dangnguyen06-ee/Autonomous_Rover_PCB/manufacturing/Autonomous_Rover_v1.pdf

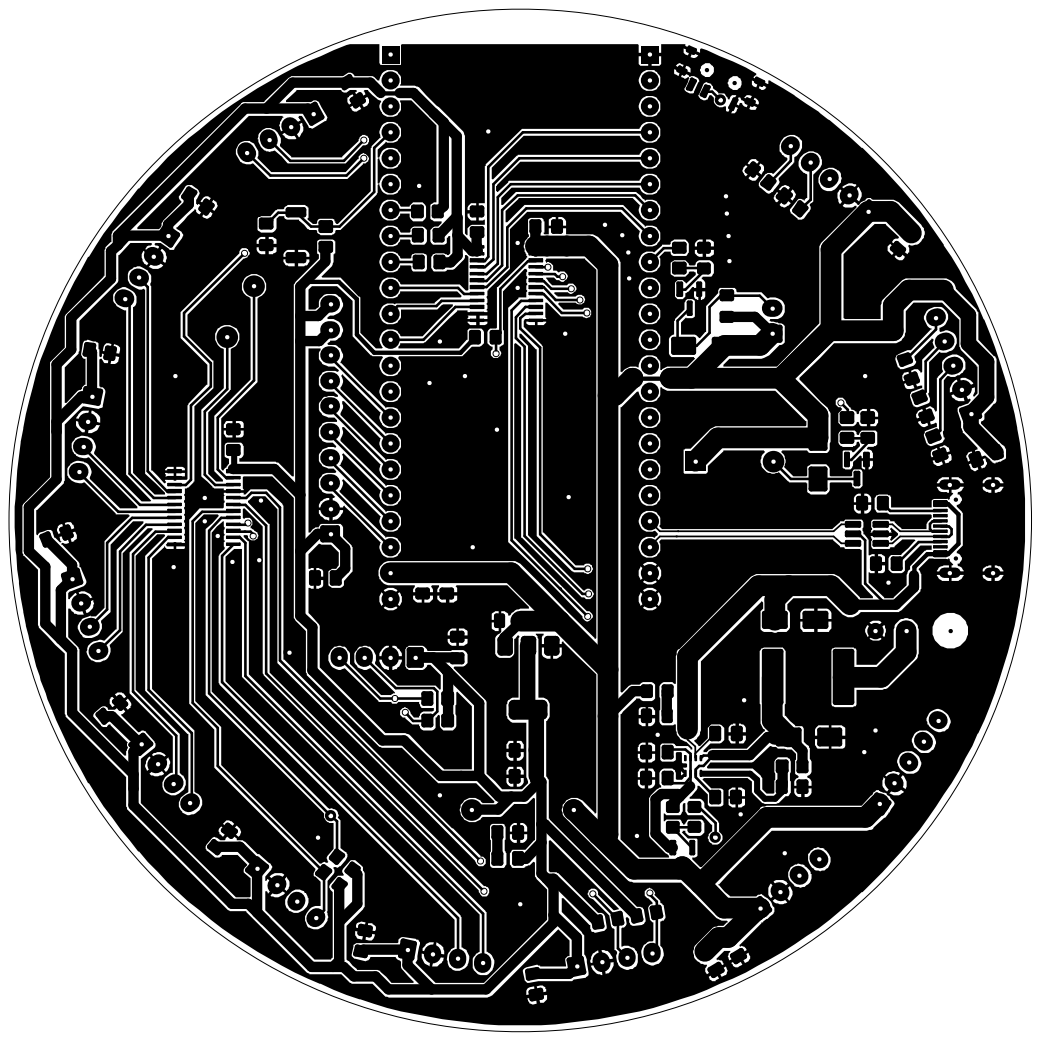
[picture p1: page 1]
