dangnguyen06-ee/Autonomous_Rover_PCB/Autonomous_Rover.kicad_pcb

## KiCad design Autonomous_Rover.kicad_pcb (2026-11-10)

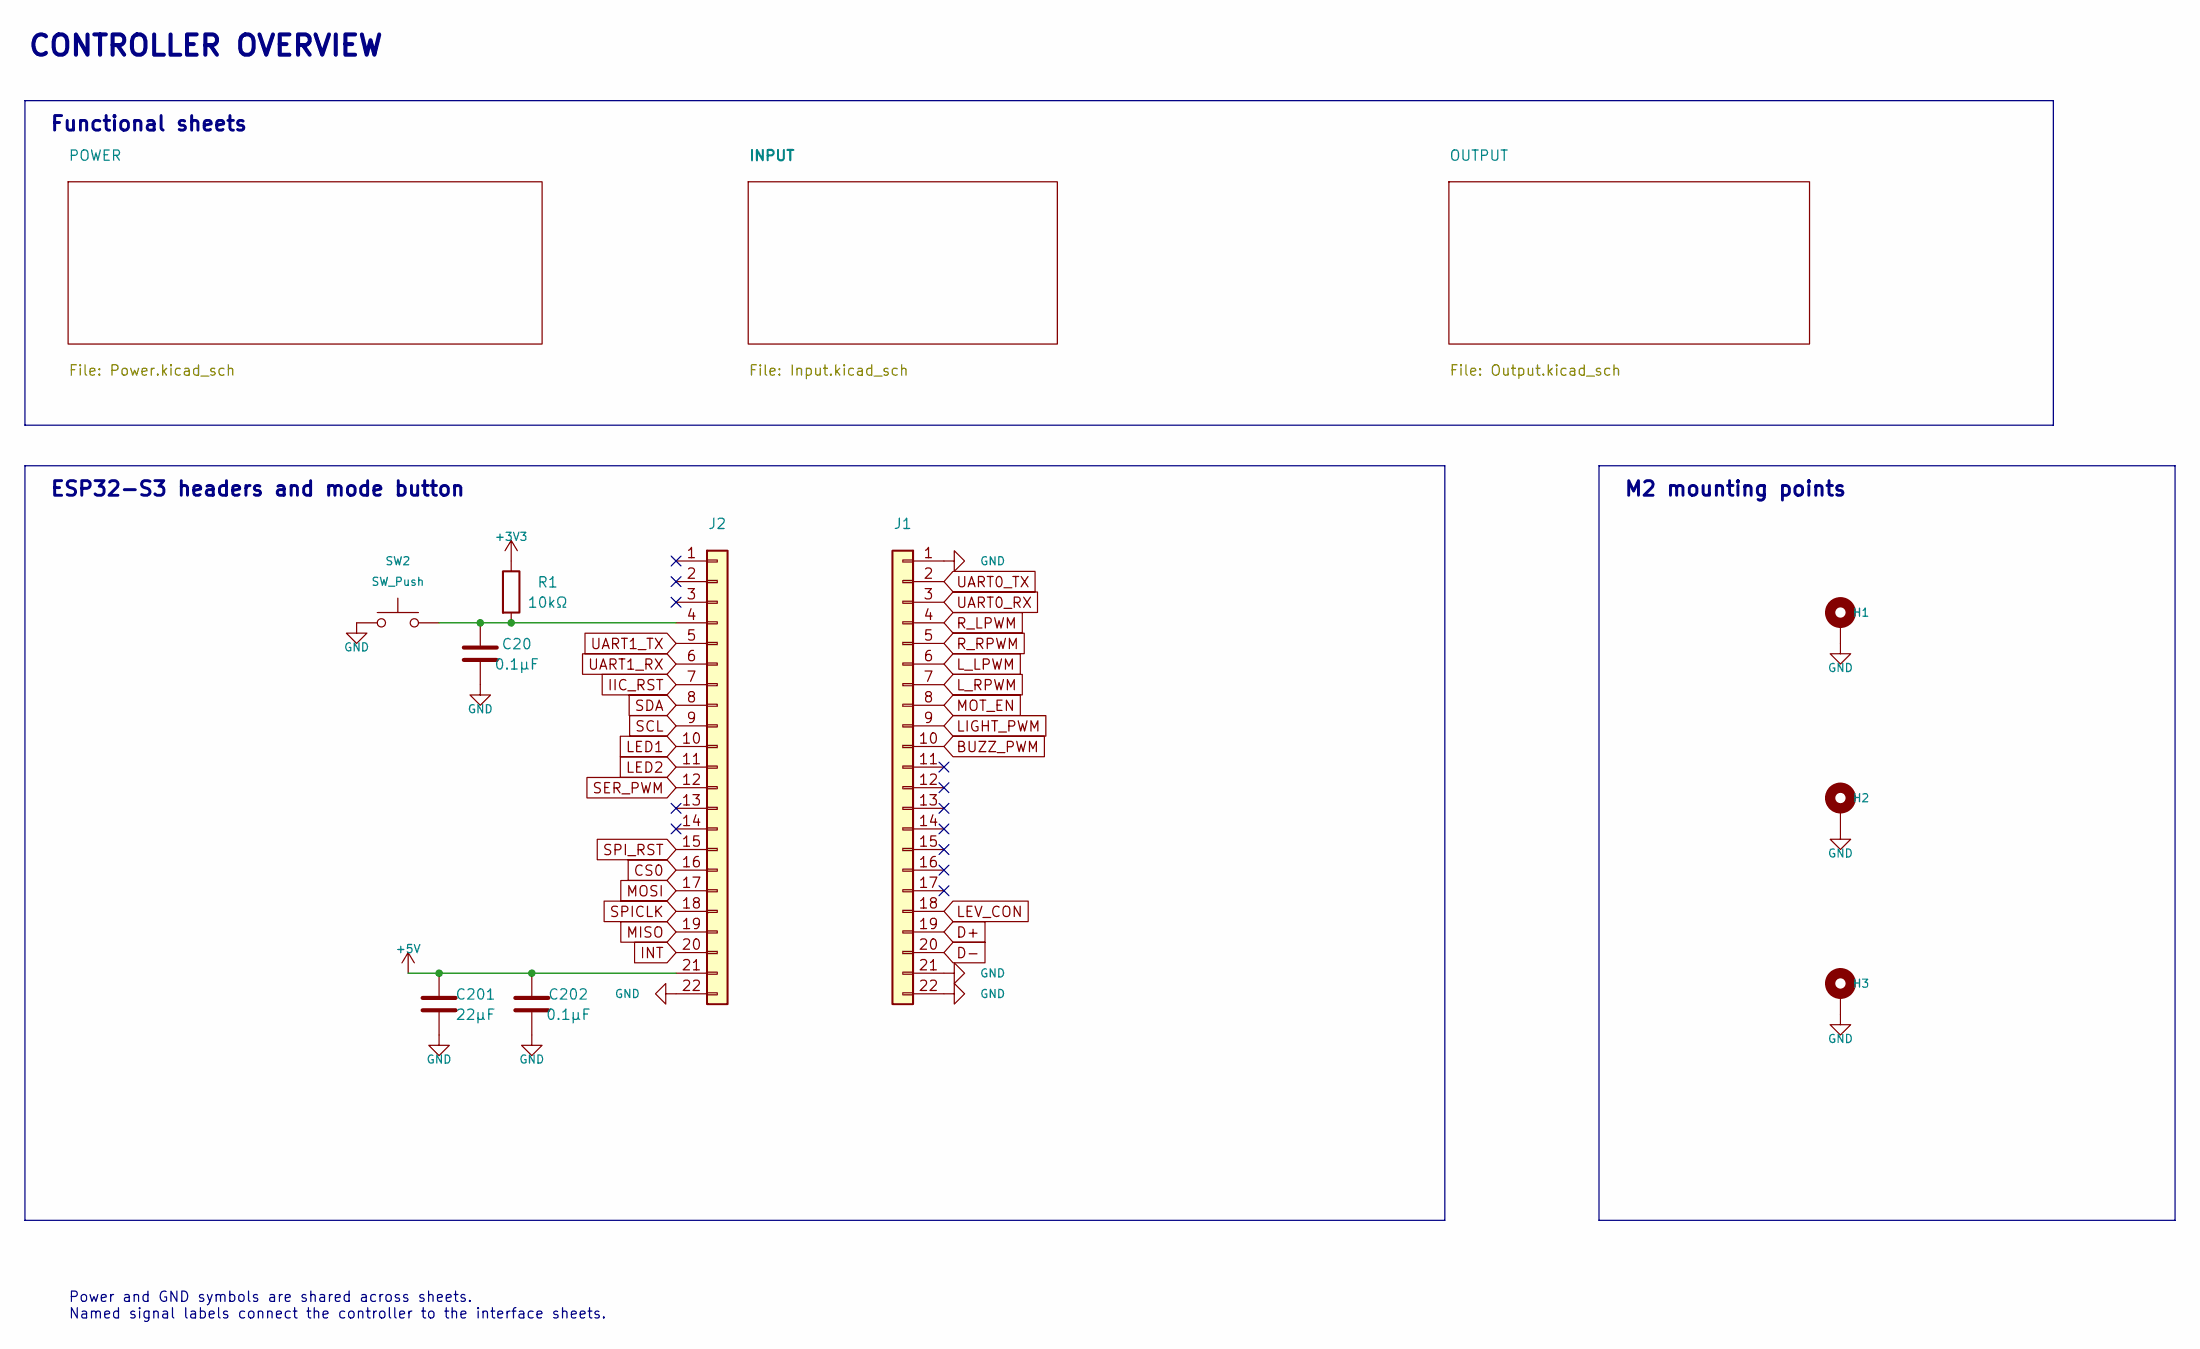
[picture p2: schematic Autonomous_Rover.kicad_sch, Parker the Rover - controller overview]

Parts:
C20, C202: 0.1µF; C_0805_2012Metric_Pad1.18x1.45mm_HandSolder
C201: 22µF; C_0805_2012Metric_Pad1.18x1.45mm_HandSolder
H1, H2, H3: M2; MountingHole_2.2mm_M2_ISO7380_Pad
J1: ESP32_R; PinSocket_1x22_P2.54mm_Vertical
J2: ESP32_L; PinSocket_1x22_P2.54mm_Vertical
R1: 10kΩ; R_0805_2012Metric_Pad1.20x1.40mm_HandSolder
SW2: SW_Push; SW_SPST_TS-1088-xR020

Connections:
+3V3: R1.1; also elsewhere on the board
+5V: C201.2, C202.2, J2.21; also elsewhere on the board
BUZZ_PWM: J1.10; also elsewhere on the board
CS0: J2.16; also elsewhere on the board
D+: J1.19; also elsewhere on the board
D-: J1.20; also elsewhere on the board
GND: C20.1, C201.1, C202.1, H1.1 (1_1), H2.1 (1_1), H3.1 (1_1), J1.1, J1.21, J1.22, J2.22, SW2.1; also elsewhere on the board
IIC_RST: J2.7; also elsewhere on the board
INT: J2.20; also elsewhere on the board
LED1: J2.10; also elsewhere on the board
LED2: J2.11; also elsewhere on the board
LEV_CON: J1.18; also elsewhere on the board
LIGHT_PWM: J1.9; also elsewhere on the board
L_LPWM: J1.6; also elsewhere on the board
L_RPWM: J1.7; also elsewhere on the board
MISO: J2.19; also elsewhere on the board
MOSI: J2.17; also elsewhere on the board
MOT_EN: J1.8; also elsewhere on the board
unnamed: C20.2, J2.4, R1.2, SW2.2
R_LPWM: J1.4; also elsewhere on the board
R_RPWM: J1.5; also elsewhere on the board
SCL: J2.9; also elsewhere on the board
SDA: J2.8; also elsewhere on the board
SER_PWM: J2.12; also elsewhere on the board
SPICLK: J2.18; also elsewhere on the board
SPI_RST: J2.15; also elsewhere on the board
UART0_RX: J1.3; also elsewhere on the board
UART0_TX: J1.2; also elsewhere on the board
UART1_RX: J2.6; also elsewhere on the board
UART1_TX: J2.5; also elsewhere on the board

Notes on the sheet:
M2 mounting points
Functional sheets
ESP32-S3 headers and mode button
CONTROLLER OVERVIEW
Power and GND symbols are shared across sheets. Named signal labels connect the controller to the interface sheets.

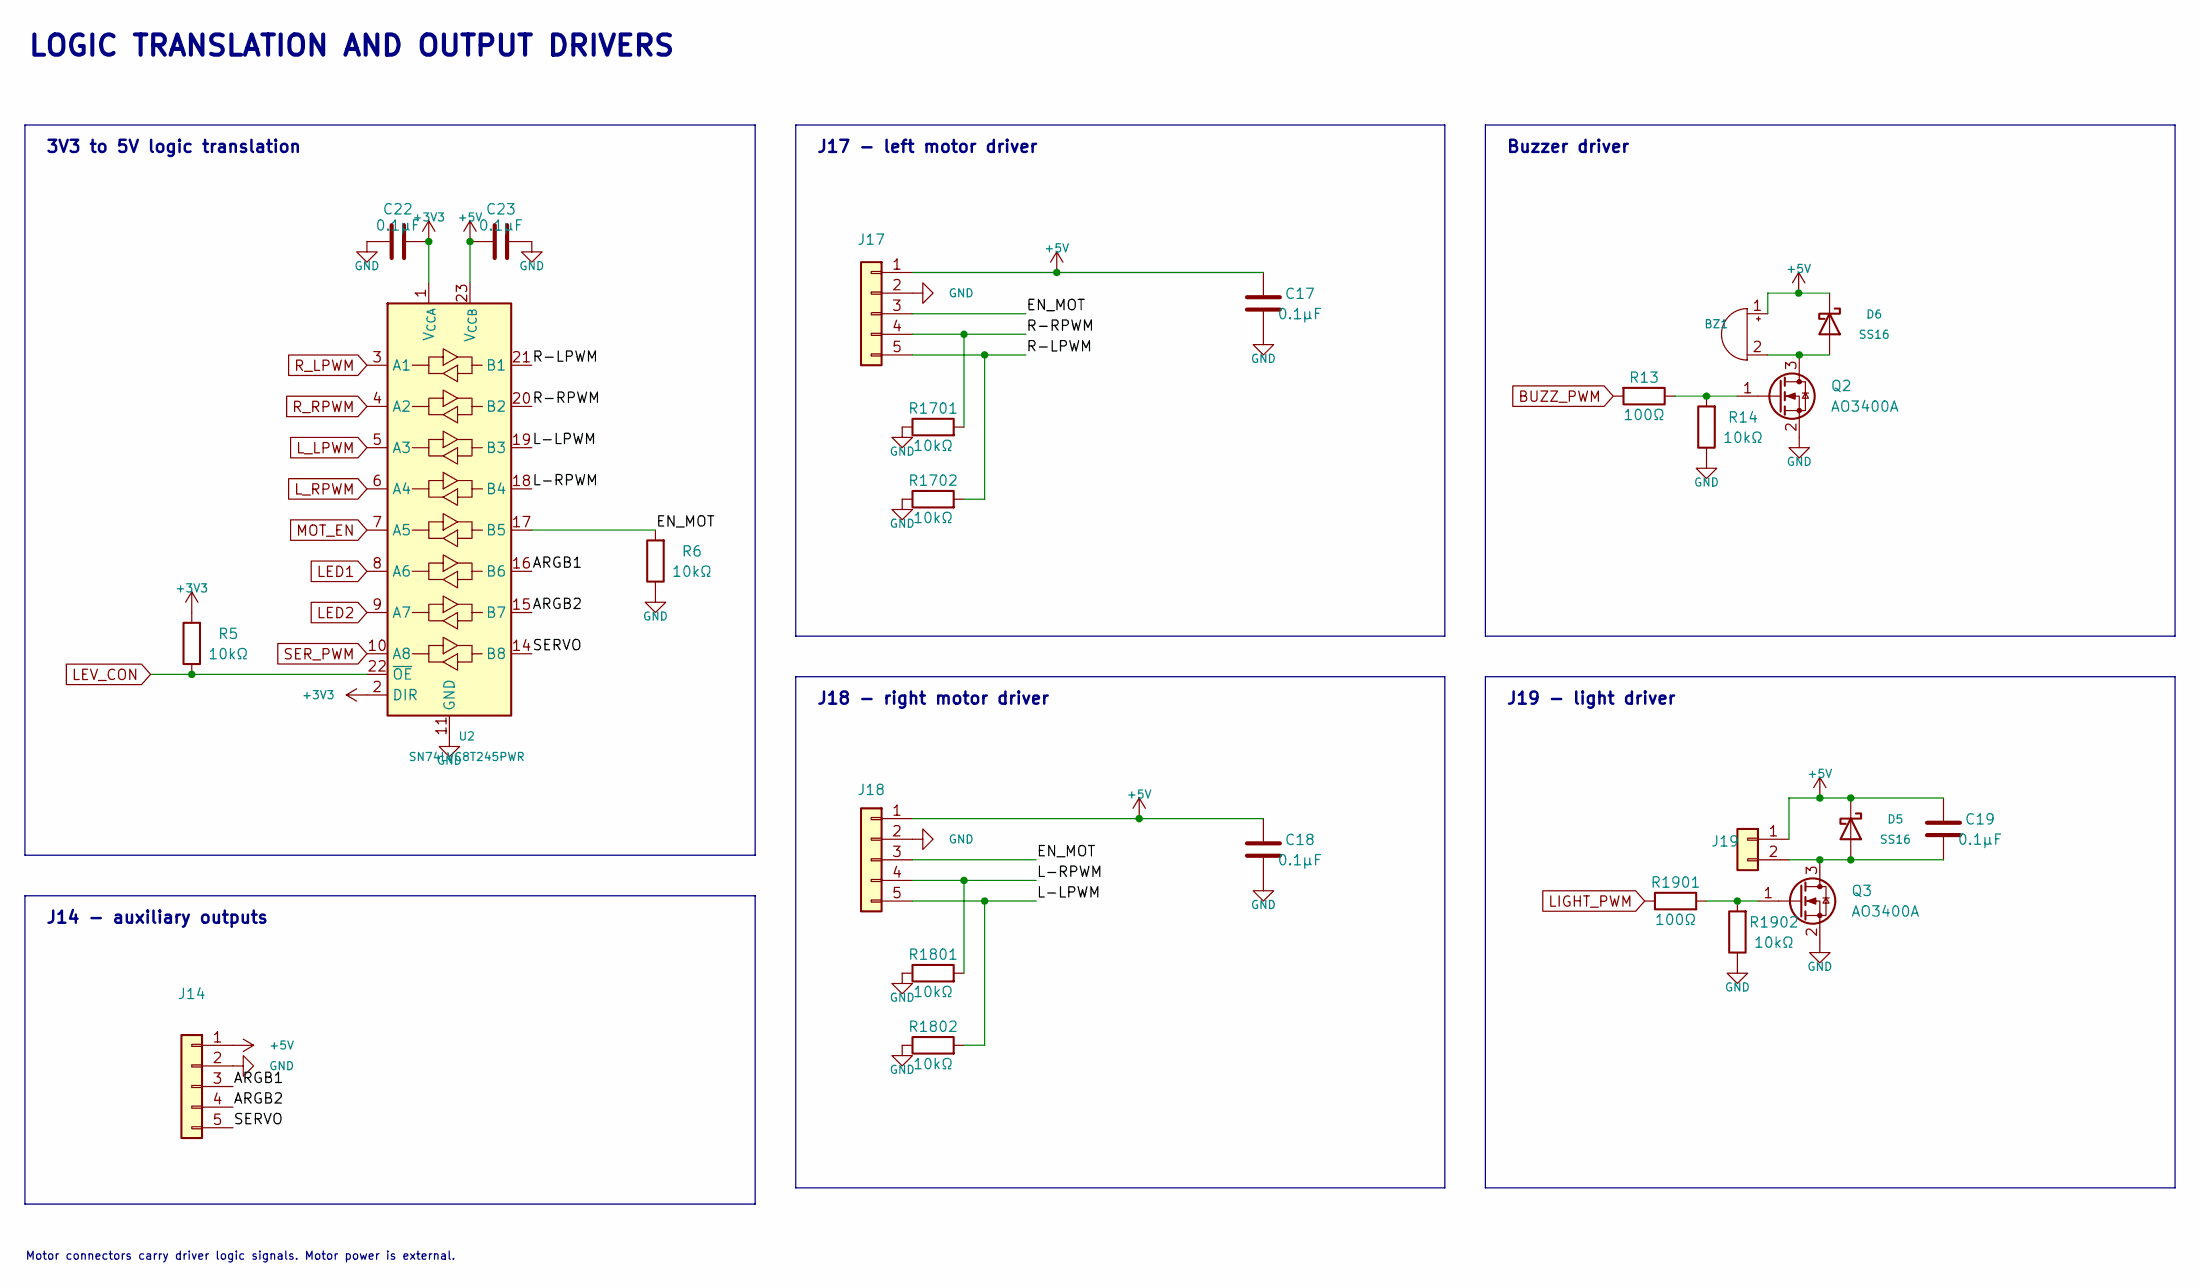
[picture p3: schematic Output.kicad_sch, Parker the Rover - logic translation and output drivers]

Parts:
BZ1: Buzzer; Buzzer_12x9.5RM7.6
C17, C18, C19, C22, C23: 0.1µF; C_0805_2012Metric_Pad1.18x1.45mm_HandSolder
D5, D6: SS16; D_SMA
J14: 5V_Con; JST_XH_B5B-XH-A_1x05_P2.50mm_Vertical
J17: L_MOT; JST_XH_B5B-XH-A_1x05_P2.50mm_Vertical
J18: R_MOT; JST_XH_B5B-XH-A_1x05_P2.50mm_Vertical
J19: BEAM_LIGHT; JST_XH_B2B-XH-A_1x02_P2.50mm_Vertical
Q2, Q3: AO3400A; SOT-23
R5, R6, R14, R1701, R1702, R1801, R1802, R1902: 10kΩ; R_0805_2012Metric_Pad1.20x1.40mm_HandSolder
R13, R1901: 100Ω; R_0805_2012Metric_Pad1.20x1.40mm_HandSolder
U2: SN74LVC8T245PWR; TSSOP-24_4.4x7.8mm_P0.65mm

Connections:
+3V3: C22.2, R5.2, U2.1 (V_{CCA}), U2.2 (DIR); also elsewhere on the board
+5V: BZ1.1 (+), C17.2, C18.2, C19.1, C23.2, D5.1 (K), D6.1 (K), J14.1, J17.1, J18.1, J19.1, U2.23 (V_{CCB}), U2.24 (V_{CCB}); also elsewhere on the board
/OUTPUT/ARGB1: J14.3, U2.16 (B6)
/OUTPUT/ARGB2: J14.4, U2.15 (B7)
/OUTPUT/EN_MOT: J17.3, J18.3, R6.2, U2.17 (B5)
/OUTPUT/L-LPWM: J18.5, R1802.2, U2.19 (B3)
/OUTPUT/L-RPWM: J18.4, R1801.2, U2.18 (B4)
/OUTPUT/R-LPWM: J17.5, R1702.2, U2.21 (B1)
/OUTPUT/R-RPWM: J17.4, R1701.2, U2.20 (B2)
/OUTPUT/SERVO: J14.5, U2.14 (B8)
BUZZ_PWM: R13.2; also elsewhere on the board
GND: C17.1, C18.1, C22.1, C23.1, J14.2, J17.2, J18.2, Q2.2 (S), Q3.2 (S), R6.1, R14.1, R1701.1, R1702.1, R1801.1, R1802.1, R1902.1, U2.11 (GND), U2.12 (GND), U2.13 (GND); also elsewhere on the board
LED1: U2.8 (A6); also elsewhere on the board
LED2: U2.9 (A7); also elsewhere on the board
LEV_CON: R5.1, U2.22 (~OE); also elsewhere on the board
LIGHT_PWM: R1901.1; also elsewhere on the board
L_LPWM: U2.5 (A3); also elsewhere on the board
L_RPWM: U2.6 (A4); also elsewhere on the board
MOT_EN: U2.7 (A5); also elsewhere on the board
unnamed: BZ1.2 (-), D6.2 (A), Q2.3 (D)
unnamed: C19.2, D5.2 (A), J19.2, Q3.3 (D)
unnamed: Q2.1 (G), R13.1, R14.2
unnamed: Q3.1 (G), R1901.2, R1902.2
R_LPWM: U2.3 (A1); also elsewhere on the board
R_RPWM: U2.4 (A2); also elsewhere on the board
SER_PWM: U2.10 (A8); also elsewhere on the board

Notes on the sheet:
3V3 to 5V logic translation
Motor connectors carry driver logic signals. Motor power is external.
J17 - left motor driver
J14 - auxiliary outputs
J18 - right motor driver
LOGIC TRANSLATION AND OUTPUT DRIVERS
J19 - light driver
Buzzer driver

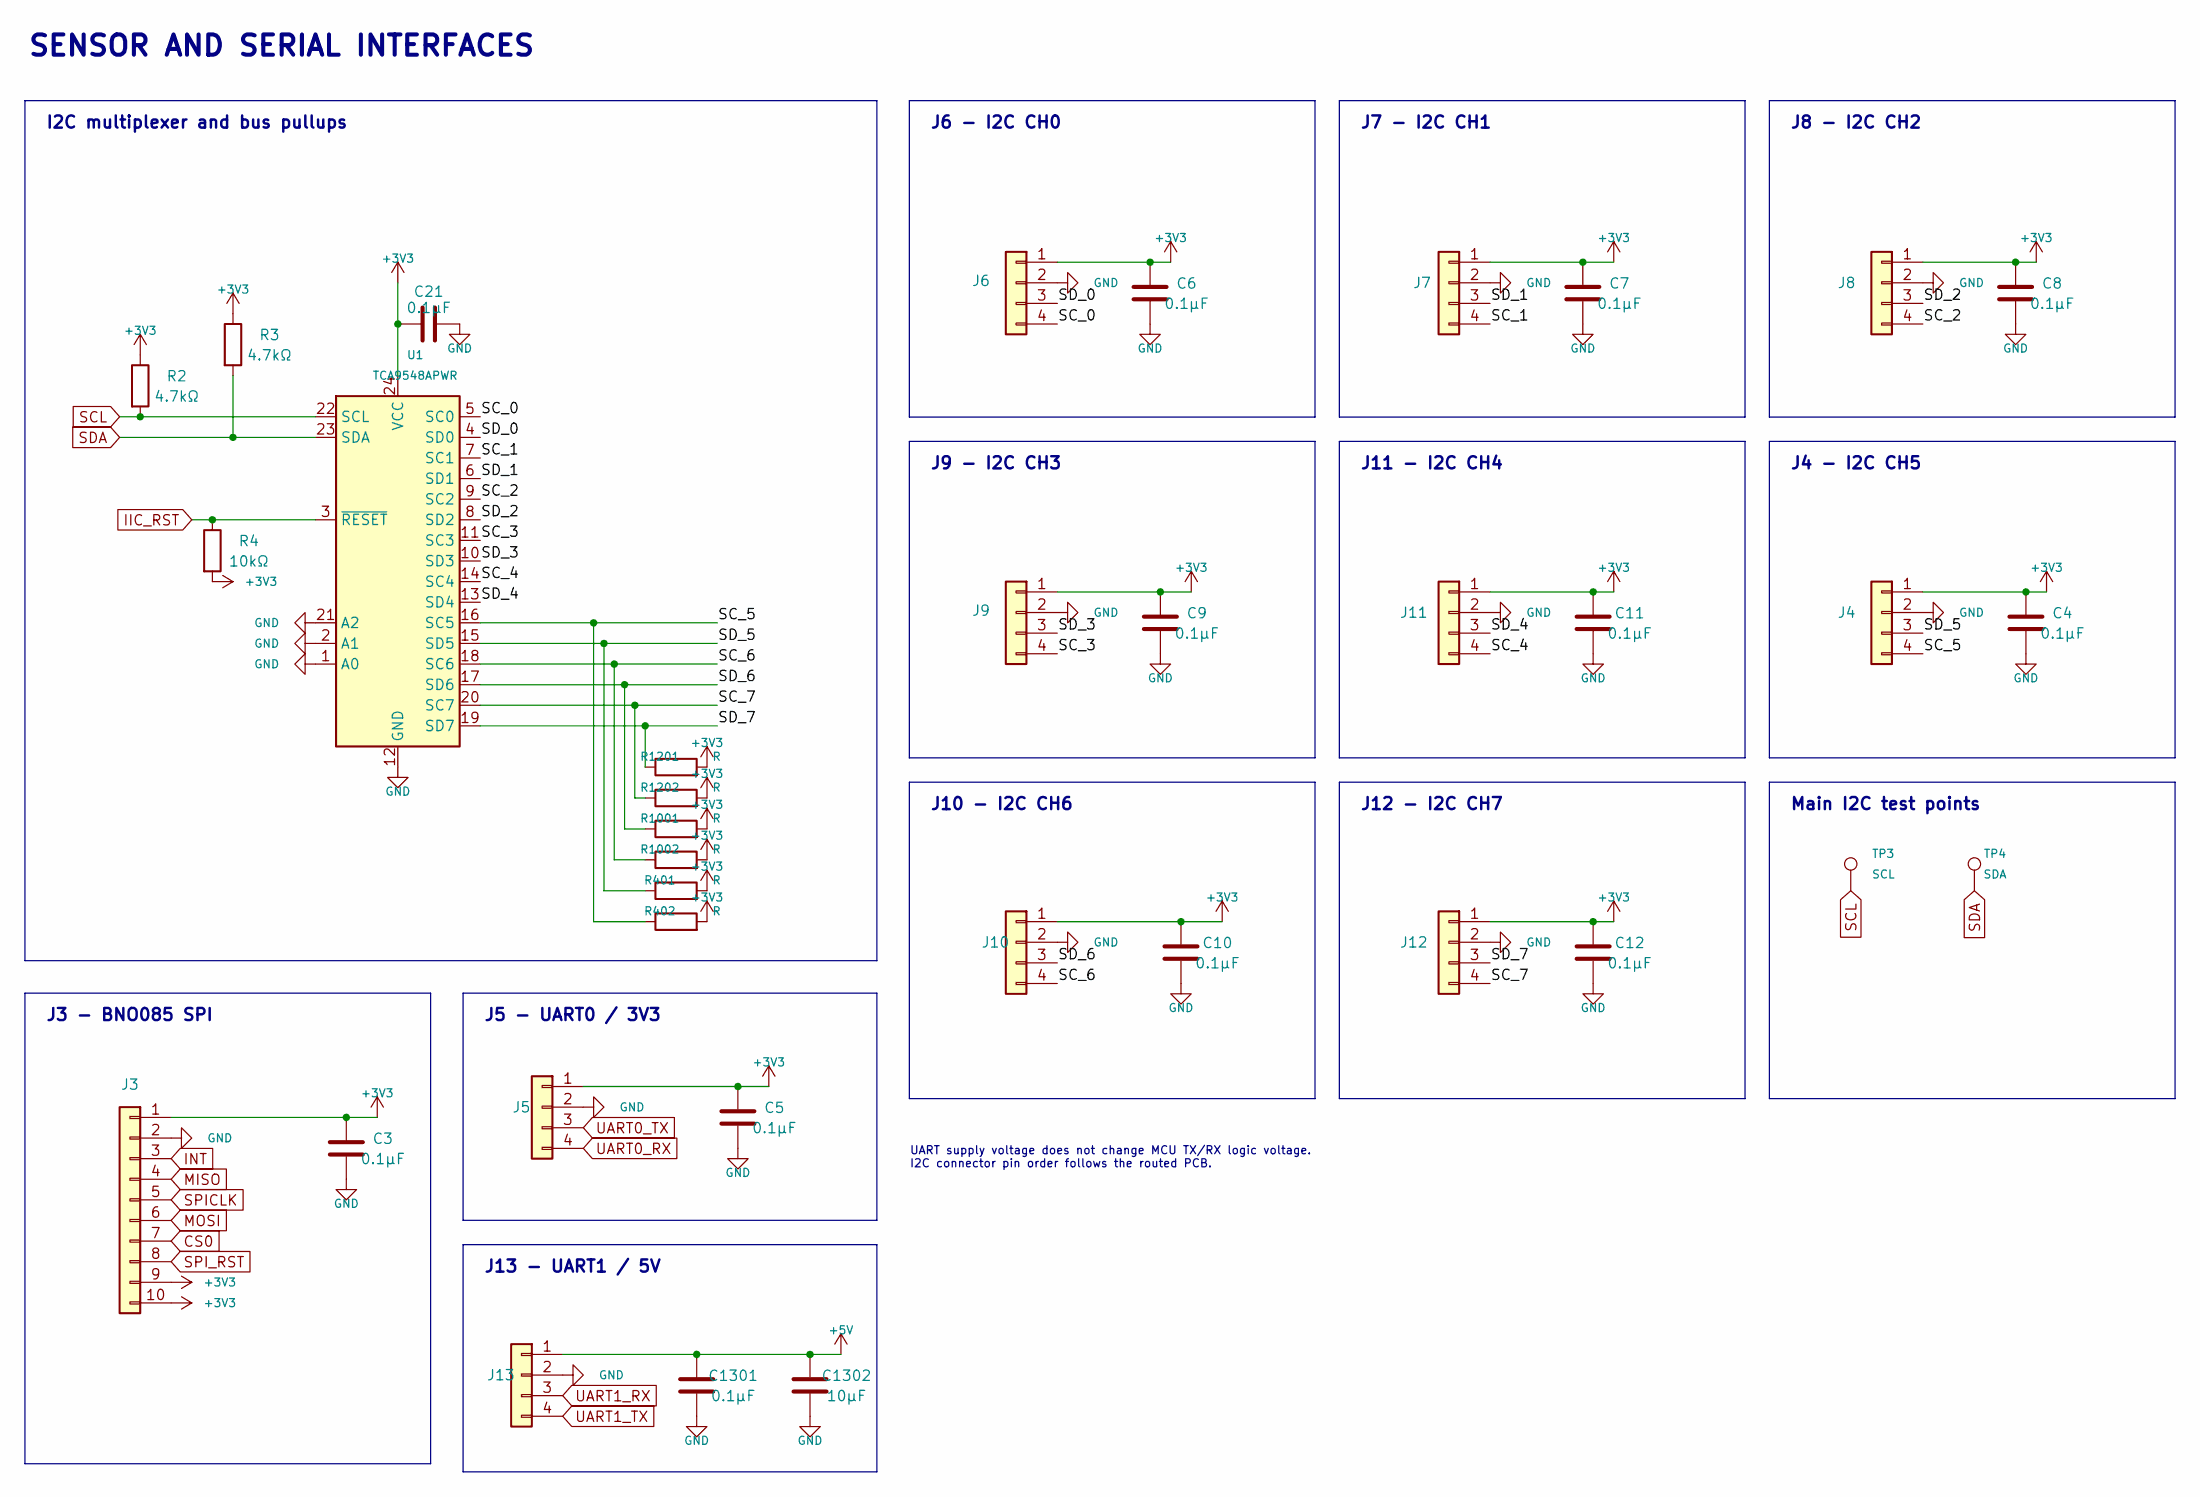
[picture p4: schematic Input.kicad_sch, Parker the Rover - sensor and serial interfaces]

Parts:
C3, C4, C5, C6, C7, C8, C9, C10, C11, C12, C21, C1301: 0.1µF; C_0805_2012Metric_Pad1.18x1.45mm_HandSolder
C1302: 10µF; C_0805_2012Metric_Pad1.18x1.45mm_HandSolder
J3: BNO085; JST_XH_B10B-XH-A_1x10_P2.50mm_Vertical
J4: I2C_CH5; JST_XH_B4B-XH-A_1x04_P2.50mm_Vertical
J5: UART0_3V; JST_XH_B4B-XH-A_1x04_P2.50mm_Vertical
J6: I2C_CH0; JST_XH_B4B-XH-A_1x04_P2.50mm_Vertical
J7: I2C_CH1; JST_XH_B4B-XH-A_1x04_P2.50mm_Vertical
J8: I2C_CH2; JST_XH_B4B-XH-A_1x04_P2.50mm_Vertical
J9: I2C_CH3; JST_XH_B4B-XH-A_1x04_P2.50mm_Vertical
J10: I2C_CH6; JST_XH_B4B-XH-A_1x04_P2.50mm_Vertical
J11: I2C_CH4; JST_XH_B4B-XH-A_1x04_P2.50mm_Vertical
J12: I2C_CH7; JST_XH_B4B-XH-A_1x04_P2.50mm_Vertical
J13: UART1_5V; JST_XH_B4B-XH-A_1x04_P2.50mm_Vertical
R2, R3: 4.7kΩ; R_0805_2012Metric_Pad1.20x1.40mm_HandSolder
R4: 10kΩ; R_0805_2012Metric_Pad1.20x1.40mm_HandSolder
R401, R402, R1001, R1002, R1201, R1202: R; R_0805_2012Metric_Pad1.20x1.40mm_HandSolder
TP3: SCL; TestPoint_Loop_D1.80mm_Drill1.0mm_Beaded
TP4: SDA; TestPoint_Loop_D1.80mm_Drill1.0mm_Beaded
U1: TCA9548APWR; TSSOP-24_4.4x7.8mm_P0.65mm

Connections:
+3V3: C3.1, C4.1, C5.2, C6.1, C7.1, C8.1, C9.1, C10.1, C11.1, C12.1, C21.1, J3.1, J3.9, J3.10, J4.1, J5.1, J6.1, J7.1, J8.1, J9.1, J10.1, J11.1, J12.1, R2.1, R3.1, R4.2, R401.2, R402.2, R1001.2, R1002.2, R1201.2, R1202.2, U1.24 (VCC); also elsewhere on the board
+5V: C1301.2, C1302.2, J13.1; also elsewhere on the board
/INPUT/SC_0: J6.4, U1.5 (SC0)
/INPUT/SC_1: J7.4, U1.7 (SC1)
/INPUT/SC_2: J8.4, U1.9 (SC2)
/INPUT/SC_3: J9.4, U1.11 (SC3)
/INPUT/SC_4: J11.4, U1.14 (SC4)
/INPUT/SC_5: J4.4, R402.1, U1.16 (SC5)
/INPUT/SC_6: J10.4, R1002.1, U1.18 (SC6)
/INPUT/SC_7: J12.4, R1202.1, U1.20 (SC7)
/INPUT/SD_0: J6.3, U1.4 (SD0)
/INPUT/SD_1: J7.3, U1.6 (SD1)
/INPUT/SD_2: J8.3, U1.8 (SD2)
/INPUT/SD_3: J9.3, U1.10 (SD3)
/INPUT/SD_4: J11.3, U1.13 (SD4)
/INPUT/SD_5: J4.3, R401.1, U1.15 (SD5)
/INPUT/SD_6: J10.3, R1001.1, U1.17 (SD6)
/INPUT/SD_7: J12.3, R1201.1, U1.19 (SD7)
CS0: J3.7; also elsewhere on the board
GND: C3.2, C4.2, C5.1, C6.2, C7.2, C8.2, C9.2, C10.2, C11.2, C12.2, C21.2, C1301.1, C1302.1, J3.2, J4.2, J5.2, J6.2, J7.2, J8.2, J9.2, J10.2, J11.2, J12.2, J13.2, U1.1 (A0), U1.2 (A1), U1.12 (GND), U1.21 (A2); also elsewhere on the board
IIC_RST: R4.1, U1.3 (~RESET); also elsewhere on the board
INT: J3.3; also elsewhere on the board
MISO: J3.4; also elsewhere on the board
MOSI: J3.6; also elsewhere on the board
SCL: R2.2, TP3.1 (1_1), U1.22 (SCL); also elsewhere on the board
SDA: R3.2, TP4.1 (1_1), U1.23 (SDA); also elsewhere on the board
SPICLK: J3.5; also elsewhere on the board
SPI_RST: J3.8; also elsewhere on the board
UART0_RX: J5.4; also elsewhere on the board
UART0_TX: J5.3; also elsewhere on the board
UART1_RX: J13.3; also elsewhere on the board
UART1_TX: J13.4; also elsewhere on the board

Notes on the sheet:
J7 - I2C CH1
J12 - I2C CH7
J8 - I2C CH2
J3 - BNO085 SPI
UART supply voltage does not change MCU TX/RX logic voltage. I2C connector pin order follows the routed PCB.
J5 - UART0 / 3V3
J9 - I2C CH3
J6 - I2C CH0
Main I2C test points
J4 - I2C CH5
J11 - I2C CH4
I2C multiplexer and bus pullups
SENSOR AND SERIAL INTERFACES
J13 - UART1 / 5V
J10 - I2C CH6

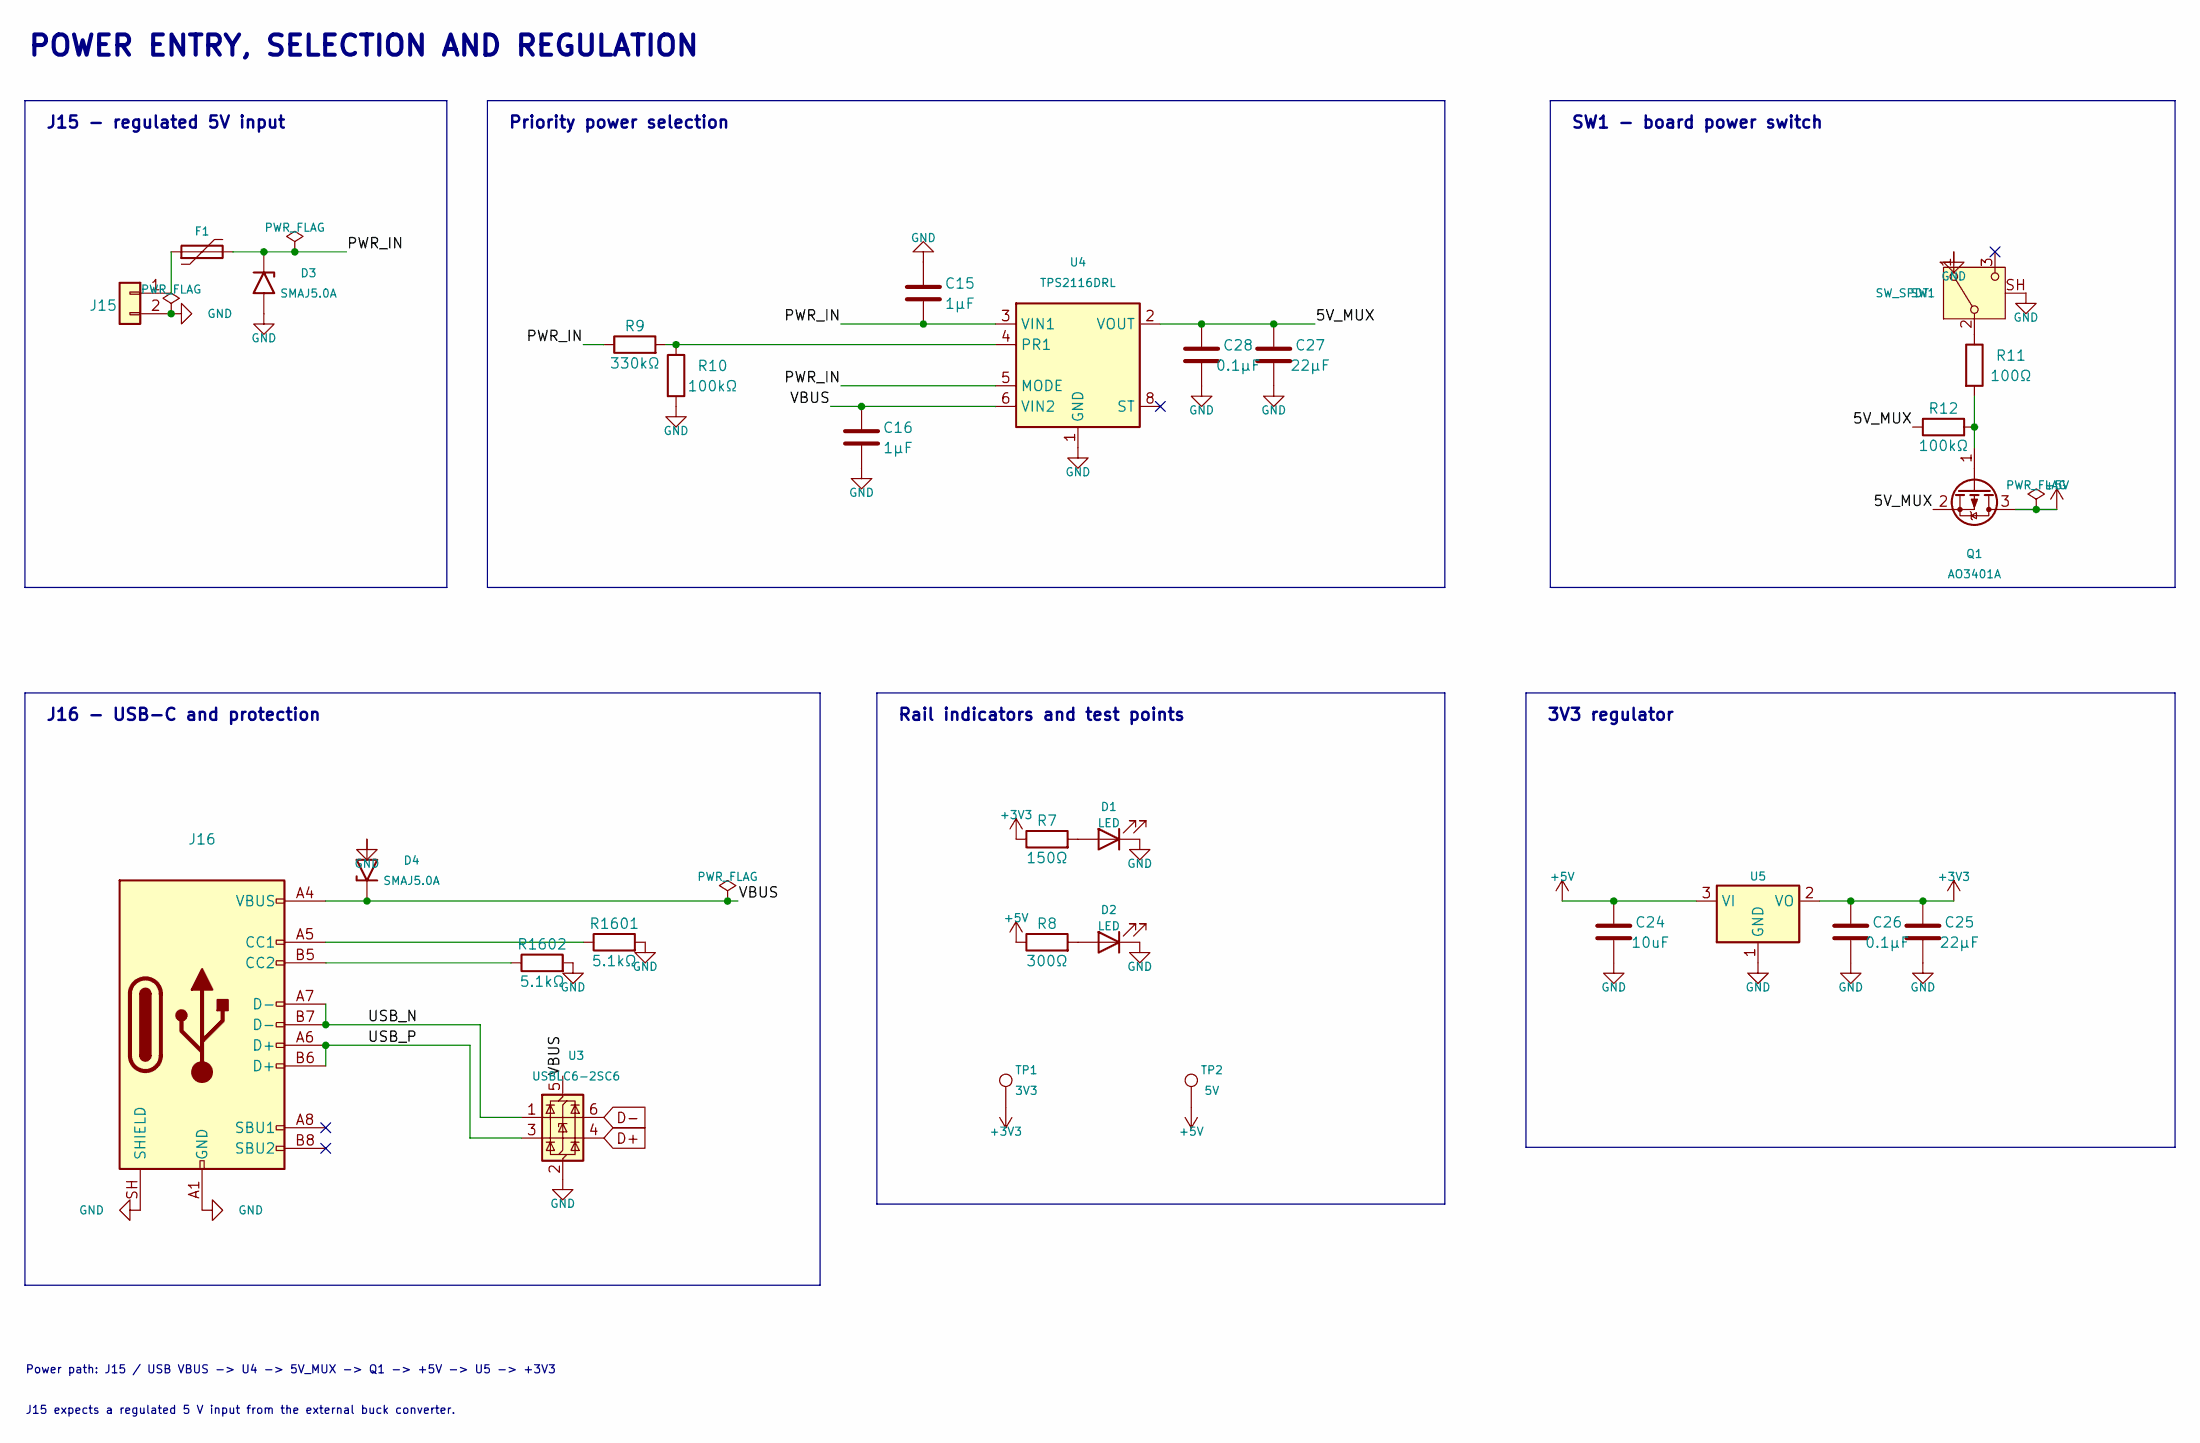
[picture p5: schematic Power.kicad_sch, Parker the Rover - power entry, selection and regulation]

Parts:
C15, C16: 1µF; C_0805_2012Metric_Pad1.18x1.45mm_HandSolder
C24: 10uF; C_0805_2012Metric_Pad1.18x1.45mm_HandSolder
C25, C27: 22µF; C_0805_2012Metric_Pad1.18x1.45mm_HandSolder
C26, C28: 0.1µF; C_0805_2012Metric_Pad1.18x1.45mm_HandSolder
D1, D2: LED; LED_0805_2012Metric_Pad1.15x1.40mm_HandSolder
D3, D4: SMAJ5.0A; D_SMA
F1: 1.85A Hold / 3.7A Trip; Fuse_2920_7451Metric_Pad2.10x5.45mm_HandSolder
J15: POWER; Molex_Micro-Fit_3.0_43045-0200_2x01_P3.00mm_Horizontal
J16: USB_C_Receptacle_USB2.0_16P; USB_C_Receptacle_HRO_TYPE-C-31-M-12
Q1: AO3401A; SOT-23
R7: 150Ω; R_0805_2012Metric_Pad1.20x1.40mm_HandSolder
R8: 300Ω; R_0805_2012Metric_Pad1.20x1.40mm_HandSolder
R9: 330kΩ; R_0805_2012Metric_Pad1.20x1.40mm_HandSolder
R10, R12: 100kΩ; R_0805_2012Metric_Pad1.20x1.40mm_HandSolder
R11: 100Ω; R_0805_2012Metric_Pad1.20x1.40mm_HandSolder
R1601, R1602: 5.1kΩ; R_0805_2012Metric_Pad1.20x1.40mm_HandSolder
SW1: SW_SPDT; SW_SPDT_Shouhan_MSK12C02
TP1: 3V3; TestPoint_Loop_D1.80mm_Drill1.0mm_Beaded
TP2: 5V; TestPoint_Loop_D1.80mm_Drill1.0mm_Beaded
U3: USBLC6-2SC6; SOT-23-6_Handsoldering
U4: TPS2116DRL; SOT-583-8
U5: AMS1117-3.3; SOT-223-3_TabPin2

Connections:
+3V3: C25.1, C26.2, R7.1, TP1.1 (1_1), U5.2 (VO); also elsewhere on the board
+5V: C24.1, Q1.3 (D), R8.1, TP2.1 (1_1), U5.3 (VI); also elsewhere on the board
/POWER/5V_MUX: C27.1, C28.2, Q1.2 (S), R12.1, U4.2 (VOUT), U4.7 (VOUT)
/POWER/PWR_IN: C15.2, D3.1 (A1), F1.2, R9.1, U4.3 (VIN1), U4.5 (MODE)
/POWER/USB_N: J16.A7 (D-), J16.B7 (D-), U3.1 (I/O1)
/POWER/USB_P: J16.A6 (D+), J16.B6 (D+), U3.3 (I/O2)
/POWER/VBUS: C16.2, D4.1 (A1), J16.A4 (VBUS), J16.A9 (VBUS), J16.B4 (VBUS), J16.B9 (VBUS), U3.5 (VBUS), U4.6 (VIN2)
D+: U3.4 (I/O2); also elsewhere on the board
D-: U3.6 (I/O1); also elsewhere on the board
GND: C15.1, C16.1, C24.2, C25.2, C26.1, C27.2, C28.1, D1.1 (K), D2.1 (K), D3.2 (A2), D4.2 (A2), J15.2, J16.A1 (GND), J16.A12 (GND), J16.B1 (GND), J16.B12 (GND), J16.SH (SHIELD), R10.2, R1601.2, R1602.2, SW1.1 (A), SW1.SH, U3.2 (GND), U4.1 (GND), U5.1 (GND); also elsewhere on the board
unnamed: D1.2 (A), R7.2
unnamed: D2.2 (A), R8.2
unnamed: F1.1, J15.1
unnamed: J16.A5 (CC1), R1601.1
unnamed: J16.B5 (CC2), R1602.1
unnamed: Q1.1 (G), R11.2, R12.2
unnamed: R11.1, SW1.2 (B)
unnamed: R9.2, R10.1, U4.4 (PR1)

Notes on the sheet:
SW1 - board power switch
Power path: J15 / USB VBUS -> U4 -> 5V_MUX -> Q1 -> +5V -> U5 -> +3V3
J15 expects a regulated 5 V input from the external buck converter.
Priority power selection
3V3 regulator
J15 - regulated 5V input
Rail indicators and test points
J16 - USB-C and protection
POWER ENTRY, SELECTION AND REGULATION

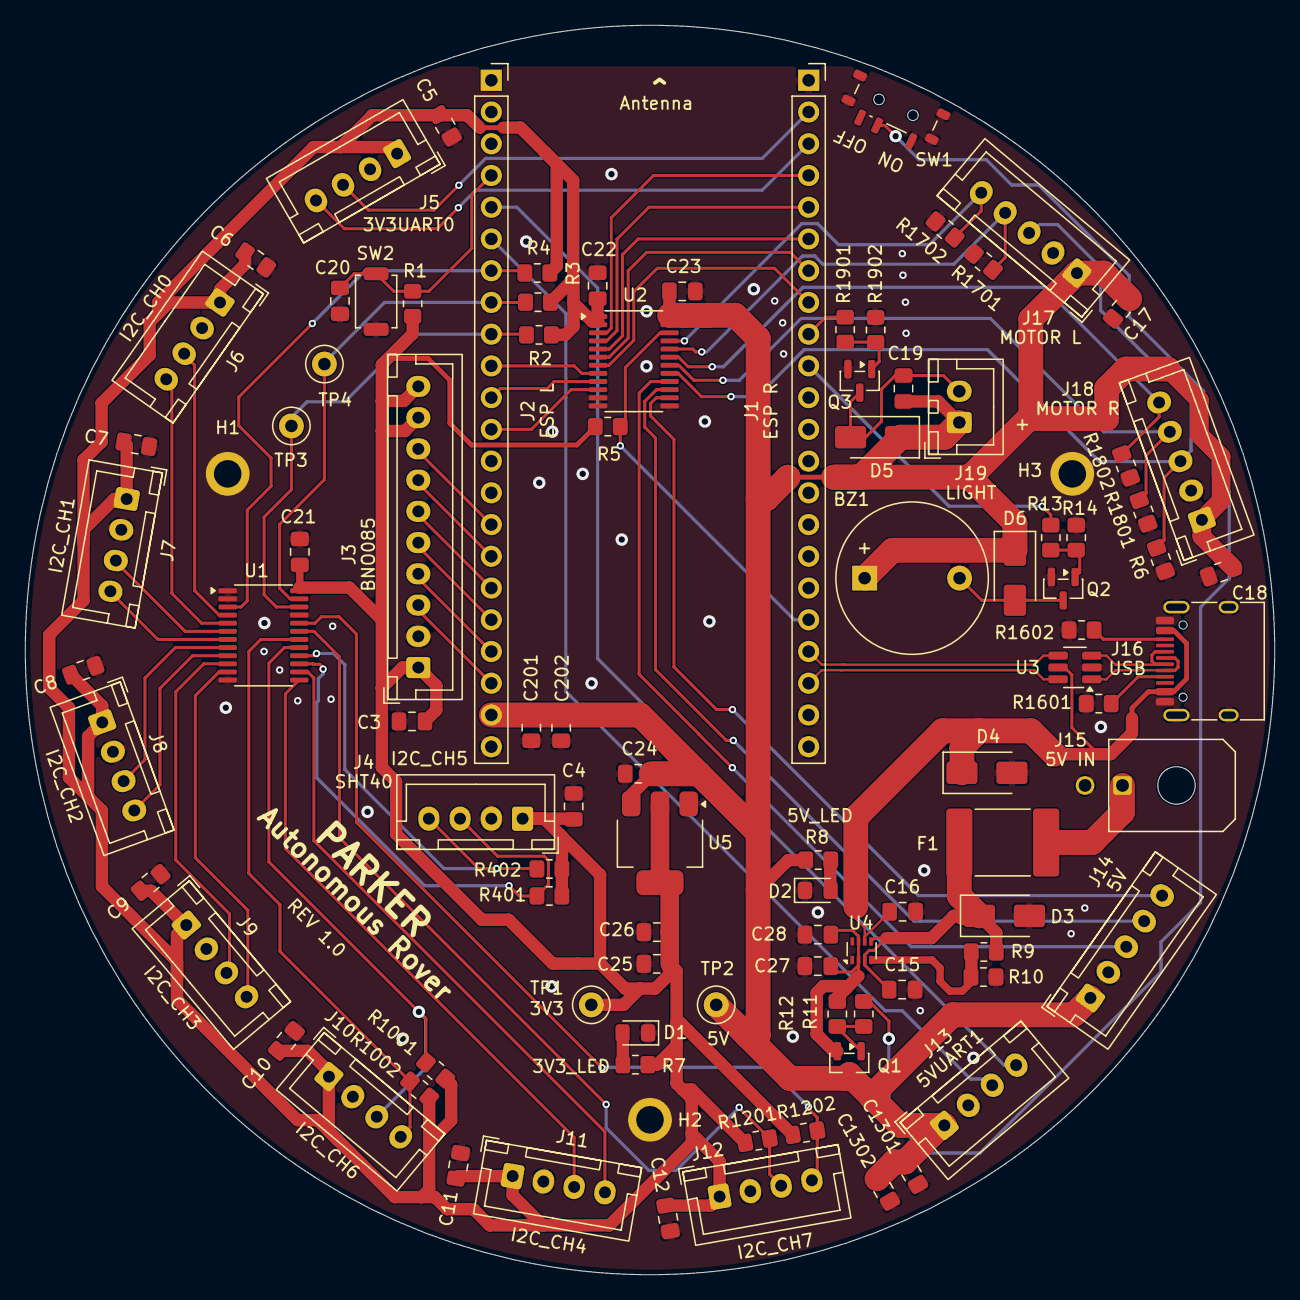
[picture p6: board Autonomous_Rover.kicad_pcb from above]

Board: 2 copper layers, 100.0 x 100.0 mm, 100 parts (0 on the bottom side), 71 nets.
