dangnguyen06-ee/Autonomous_Rover_PCB/(commit log)

2026-09-26 UART 5V and 3V
    [Autonomous_Rover.kicad_sch]
2026-09-27 Design change
    [Autonomous_Rover.kicad_pcb, Autonomous_Rover.kicad_sch]
2026-10-01 Reorganize Schematic
    [Autonomous_Rover.kicad_pcb, Autonomous_Rover.kicad_sch]
2026-11-10 Autonomous Rover PCB final V1
